rancidone/meatreader-esp/pcb/production/bom.csv

Designator | Footprint | Quantity | Value | LCSC Part #
C1, C5 | 0805 | 2 | 10uF
C10, C11, C6, C9 | 0603 | 4 | 100nF
C12, C2, C3, C7 | 0603 | 4 | 1uF
C13, C14, C15, C16 | 0603 | 4 | 47nF
C4, C8 | 0805 | 2 | 47uF
D1 | D_SMA_Handsoldering | 1 | SMAJ5 | C19077497
D2 | LED_D3.0mm | 1 | LED_PWR
D3 | LED_D3.0mm | 1 | LED_G
D4 | LED_D3.0mm | 1 | LED_R
D5 | D_SOD-323_HandSoldering | 1 | PESD3V3
D6, D7, D8, D9 | D_SOD-323_HandSoldering | 4 | PESD5V0
J1 | JST_PH_B2B-PH-K_1x02_P2.00mm_Vertical | 1 | BATT
J2 | USB_C_Receptacle_GCT_USB4125-xx-x_6P_TopMnt_Horizontal | 1 | USB_C_Receptacle_PowerOnly_6P
J3 | JST_PH_B3B-PH-K_1x03_P2.00mm_Vertical | 1 | DS18B20
J4 | PinHeader_2x03_P1.27mm_Vertical_SMD | 1 | PROG
R1, R3 | 0603 | 2 | 5K1
R10, R2 | 0603 | 2 | 100R
R11, R12, R17, R18 | 1206 | 4 | 22K
R13, R14, R19, R20 | 0603 | 4 | 470R
R15, R16, R9 | 0603 | 3 | 4K7
R4, R5 | 0603 | 2 | 1K | C11702
R6 | 0603 | 1 | 1K6
R7, R8 | 0603 | 2 | 10K
SW1 | JST_PH_B2B-PH-K_1x02_P2.00mm_Vertical | 1 | SW_SPST
SW2 | 6x3.5 Tactile Switch | 1 | RESET
SW3 | 6x3.5 Tactile Switch | 1 | BOOT
TH1, TH2, TH3, TH4 | PJ-209 | 4 | Thermistor
TP1, TP9 | TestPoint_THTPad_D2.5mm_Drill1.2mm | 2 | GND
TP11 | TestPoint_Pad_D2.5mm | 1 | AIN1
TP12 | TestPoint_Pad_D2.5mm | 1 | AIN2
TP2 | TestPoint_THTPad_D2.5mm_Drill1.2mm | 1 | 5V_USB
TP3 | TestPoint_THTPad_D2.5mm_Drill1.2mm | 1 | BATT
TP4 | TestPoint_THTPad_D2.5mm_Drill1.2mm | 1 | 3V3
TP7 | TestPoint_Pad_D2.5mm | 1 | AIN0
TP8 | TestPoint_Pad_D2.5mm | 1 | AIN3
U1 | SOT-23-5 | 1 | AP2112K-3.3
U2 | SOIC-8-1EP_3.9x4.9mm_P1.27mm_EP2.41x3.3mm | 1 | TP4056
U3 | ESP32-WROOM-32U | 1 | ESP32-WROOM-32U
U4 | TSSOP-10_3x3mm_P0.5mm | 1 | ADS1115
