rancidone/meatreader-esp/pcb/Lid.stl

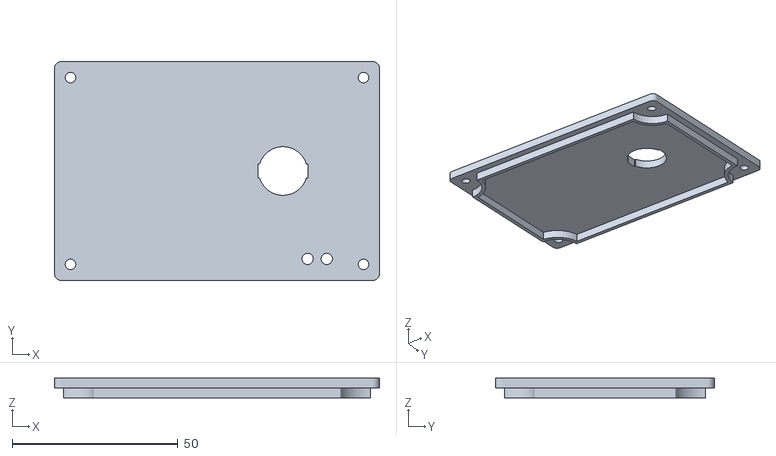
[picture p1: CAD file, 2026-11-08]
pcb/Lid.stl
98.0 x 66.0 x 6.00
