rancidone/meatreader-esp/pcb/meatreader.step

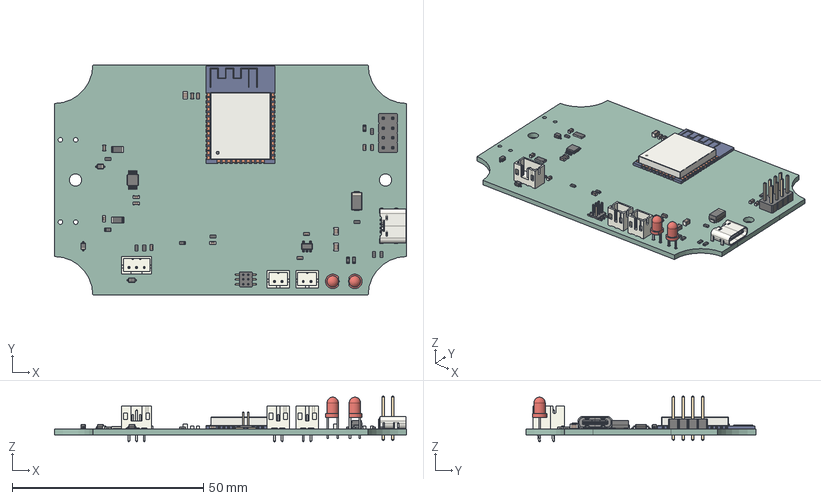
[picture p2: CAD file, 2026-11-08]
pcb/meatreader.step
92.0 x 60.0 x 11.9 mm
C_0603_1608Metric x 12
LED_D3.0mm x 2
PinHeader_2x03_P1.27mm_Vertical_SMD
D_SMA
R_1206_3216Metric x 2
D_SOD-323 x 3
R_0603_1608Metric x 13
USB_C_Receptacle_GCT_USB4125-xx-x_6P_TopMnt_Horizontal
C_0805_2012Metric x 3
JST_PH_B3B-PH-K_1x03_P2.00mm_Vertical
PinHeader_2x04_P2.54mm_Vertical
SOT-23-5
JST_PH_B2B-PH-K_1x02_P2.00mm_Vertical x 2
ESP32-WROOM-32
TSSOP-10_3x3mm_P0.5mm
meatreader_PCB
