rancidone/meatreader-esp/pcb/Pan.stl

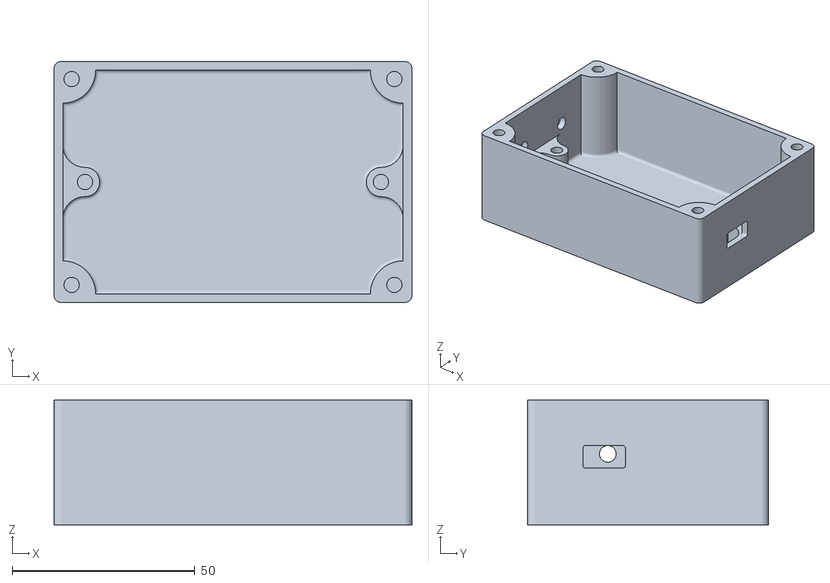
[picture p3: CAD file, 2026-11-08]
pcb/Pan.stl
98.0 x 66.0 x 34.1
