rancidone/meatreader-esp/(list of files, cad)

Other CAD files:
pcb/meatreader.stl
