rancidone/meatreader-esp/pcb/meatreader.kicad_pcb

## KiCad design pcb/meatreader.kicad_pcb (2026-11-08)

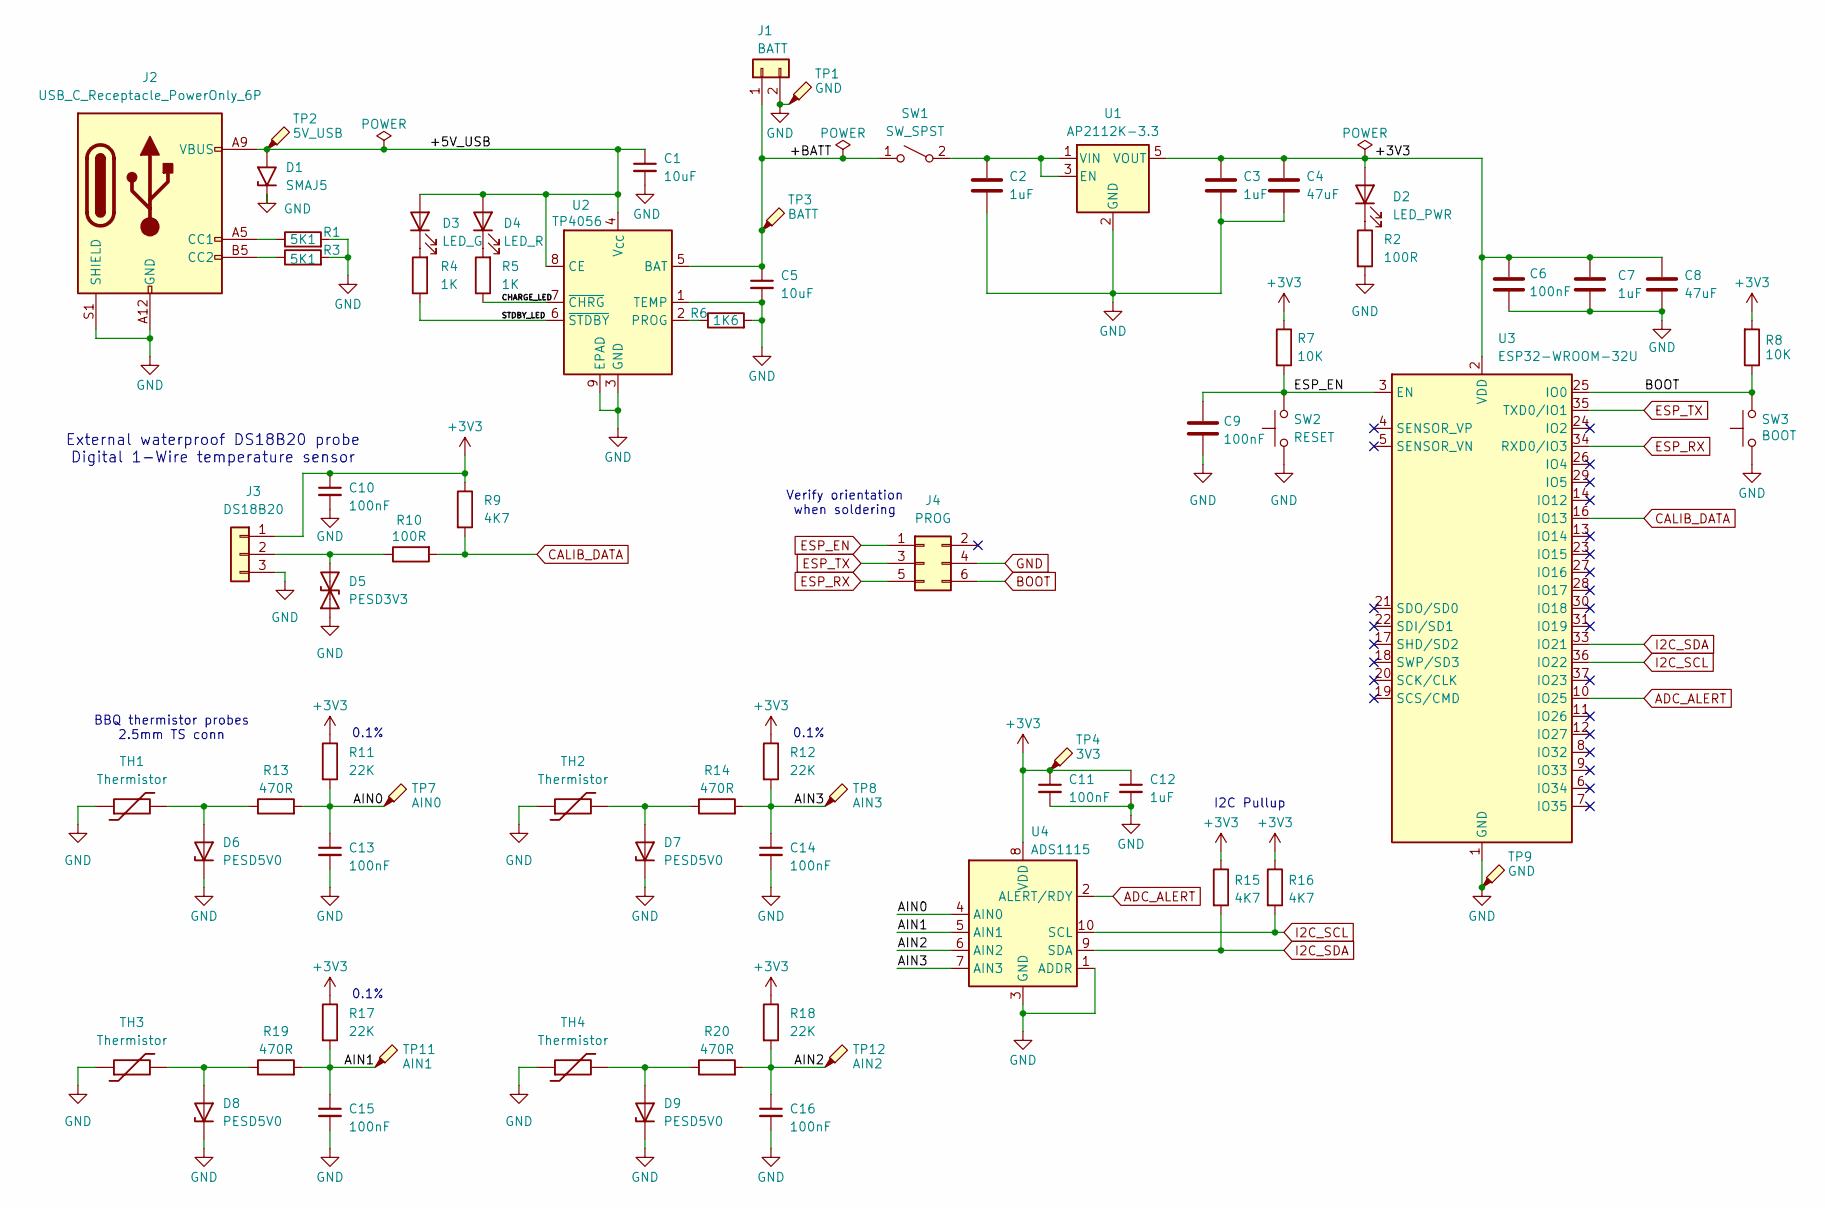
[picture p4: schematic meatreader.kicad_sch]

Parts:
C1, C5: 10uF; C_0805_2012Metric_Pad1.18x1.45mm_HandSolder
C2, C3, C7, C12: 1uF; C_0603_1608Metric_Pad1.08x0.95mm_HandSolder
C4: 47uF; R_0805_2012Metric_Pad1.20x1.40mm_HandSolder
C6, C9, C10, C11, C13, C14, C15, C16: 100nF; C_0603_1608Metric_Pad1.08x0.95mm_HandSolder
C8: 47uF; C_0805_2012Metric_Pad1.18x1.45mm_HandSolder
D1: SMAJ5; D_SMA_Handsoldering; LCSC C19077497
D2: LED_PWR; LED_D3.0mm
D3: LED_G; LED_D3.0mm
D4: LED_R; LED_D3.0mm
D5: PESD3V3; D_SOD-323_HandSoldering
D6, D7, D8, D9: PESD5V0; D_SOD-323_HandSoldering
J1: BATT; JST_PH_B2B-PH-K_1x02_P2.00mm_Vertical
J2: USB_C_Receptacle_PowerOnly_6P; USB_C_Receptacle_GCT_USB4125-xx-x_6P_TopMnt_Horizontal
J3: DS18B20; JST_PH_B3B-PH-K_1x03_P2.00mm_Vertical
J4: PROG; PinHeader_2x03_P1.27mm_Vertical_SMD
R1, R3: 5K1; R_0603_1608Metric_Pad0.98x0.95mm_HandSolder
R2: 100R; R_0603_1608Metric_Pad0.98x0.95mm_HandSolder
R4, R5: 1K; R_0603_1608Metric_Pad0.98x0.95mm_HandSolder; LCSC C11702
R6: 1K6; R_0603_1608Metric_Pad0.98x0.95mm_HandSolder
R7, R8: 10K; R_0603_1608Metric_Pad0.98x0.95mm_HandSolder
R9: 4K7; R_0603_1608Metric
R10: 100R; R_0603_1608Metric
R11, R12, R17, R18: 22K; R_1206_3216Metric_Pad1.30x1.75mm_HandSolder
R13, R14, R19, R20: 470R; R_0603_1608Metric_Pad0.98x0.95mm_HandSolder
R15, R16: 4K7; R_0603_1608Metric_Pad0.98x0.95mm_HandSolder
SW1: SW_SPST; JST_PH_B2B-PH-K_1x02_P2.00mm_Vertical
SW2: RESET; 6x3.5 Tactile Switch
SW3: BOOT; 6x3.5 Tactile Switch
TH1, TH2, TH3, TH4: Thermistor; PJ-209
TP1, TP9: GND; TestPoint_THTPad_D2.5mm_Drill1.2mm
TP2: 5V_USB; TestPoint_THTPad_D2.5mm_Drill1.2mm
TP3: BATT; TestPoint_THTPad_D2.5mm_Drill1.2mm
TP4: 3V3; TestPoint_THTPad_D2.5mm_Drill1.2mm
TP7: AIN0; TestPoint_Pad_D2.5mm
TP8: AIN3; TestPoint_Pad_D2.5mm
TP11: AIN1; TestPoint_Pad_D2.5mm
TP12: AIN2; TestPoint_Pad_D2.5mm
U1: AP2112K-3.3; SOT-23-5
U2: TP4056; SOIC-8-1EP_3.9x4.9mm_P1.27mm_EP2.41x3.3mm
U3: ESP32-WROOM-32U
U4: ADS1115; TSSOP-10_3x3mm_P0.5mm

Connections:
+3V3: C3.1, C4.1, C6.1, C7.1, C8.1, C10.1, C11.1, C12.1, D2.2 (A), J3.1, R7.1, R8.2, R9.1, R11.1, R12.1, R15.1, R16.1, R17.1, R18.1, TP4.1 (1_1), U1.5 (VOUT), U3.2 (VDD), U4.8 (VDD)
/+5V_USB: C1.1, D1.2 (A2), D3.2 (A), D4.2 (A), J2.A9 (VBUS), J2.B9 (VBUS), TP2.1 (1_1), U2.4 (V_{CC}), U2.8 (CE)
/+BATT: C5.1, J1.1, SW1.1 (B), TP3.1 (1_1), U2.5 (BAT)
/AIN0: C13.1, R11.2, R13.2, TP7.1 (1_1), U4.4 (AIN0)
/AIN1: C15.1, R17.2, R19.2, TP11.1 (1_1), U4.5 (AIN1)
/AIN2: C16.1, R18.2, R20.2, TP12.1 (1_1), U4.6 (AIN2)
/AIN3: C14.1, R12.2, R14.2, TP8.1 (1_1), U4.7 (AIN3)
/CHARGE_LED: R5.1, U2.7 (~CHRG)
/STDBY_LED: R4.1, U2.6 (~STDBY)
ADC_ALERT: U3.10 (IO25), U4.2 (ALERT/RDY)
BOOT: J4.6, R8.1, SW3.1, U3.25 (IO0)
CALIB_DATA: R9.2, R10.2, U3.16 (IO13)
ESP_EN: C9.1, J4.1, R7.2, SW2.2, U3.3 (EN)
ESP_RX: J4.5, U3.34 (RXD0/IO3)
ESP_TX: J4.3, U3.35 (TXD0/IO1)
GND: C1.2, C2.2, C3.2, C4.2, C5.2, C6.2, C7.2, C8.2, C9.2, C10.2, C11.2, C12.2, C13.2, C14.2, C15.2, C16.2, D1.1 (A1), D5.1 (A1), D6.1 (K), D7.1 (K), D8.1 (K), D9.1 (K), J1.2, J2.A12 (GND), J2.B12 (GND), J2.S1 (SHIELD), J2.SH, J3.3, J4.4, R1.2, R2.2, R3.2, R6.2, SW2.1, SW3.2, TH1.1, TH2.1, TH3.1, TH4.1, TP1.1 (1_1), TP9.1 (1_1), U1.2 (GND), U2.1 (TEMP), U2.3 (GND), U2.9 (EPAD), U3.1 (GND), U3.15 (GND), U3.38 (GND), U3.39 (GND), U4.1 (ADDR), U4.3 (GND)
I2C_SCL: R16.2, U3.36 (IO22), U4.10 (SCL)
I2C_SDA: R15.2, U3.33 (IO21), U4.9 (SDA)
unnamed: D2.1 (K), R2.1
unnamed: D3.1 (K), R4.2
unnamed: D4.1 (K), R5.2
unnamed: D5.2 (A2), J3.2, R10.1
unnamed: D6.2 (A), R13.1, TH1.2
unnamed: D7.2 (A), R14.1, TH2.2
unnamed: D8.2 (A), R19.1, TH3.2
unnamed: D9.2 (A), R20.1, TH4.2
unnamed: J2.A5 (CC1), R1.1
unnamed: J2.B5 (CC2), R3.1
unnamed: C2.1, SW1.2 (A), U1.1 (VIN), U1.3 (EN)
unnamed: R6.1, U2.2 (PROG)

Notes on the sheet:
0.1%
Verify orientation when soldering
BBQ thermistor probes 2.5mm TS conn
External waterproof DS18B20 probe Digital 1-Wire temperature sensor
I2C Pullup

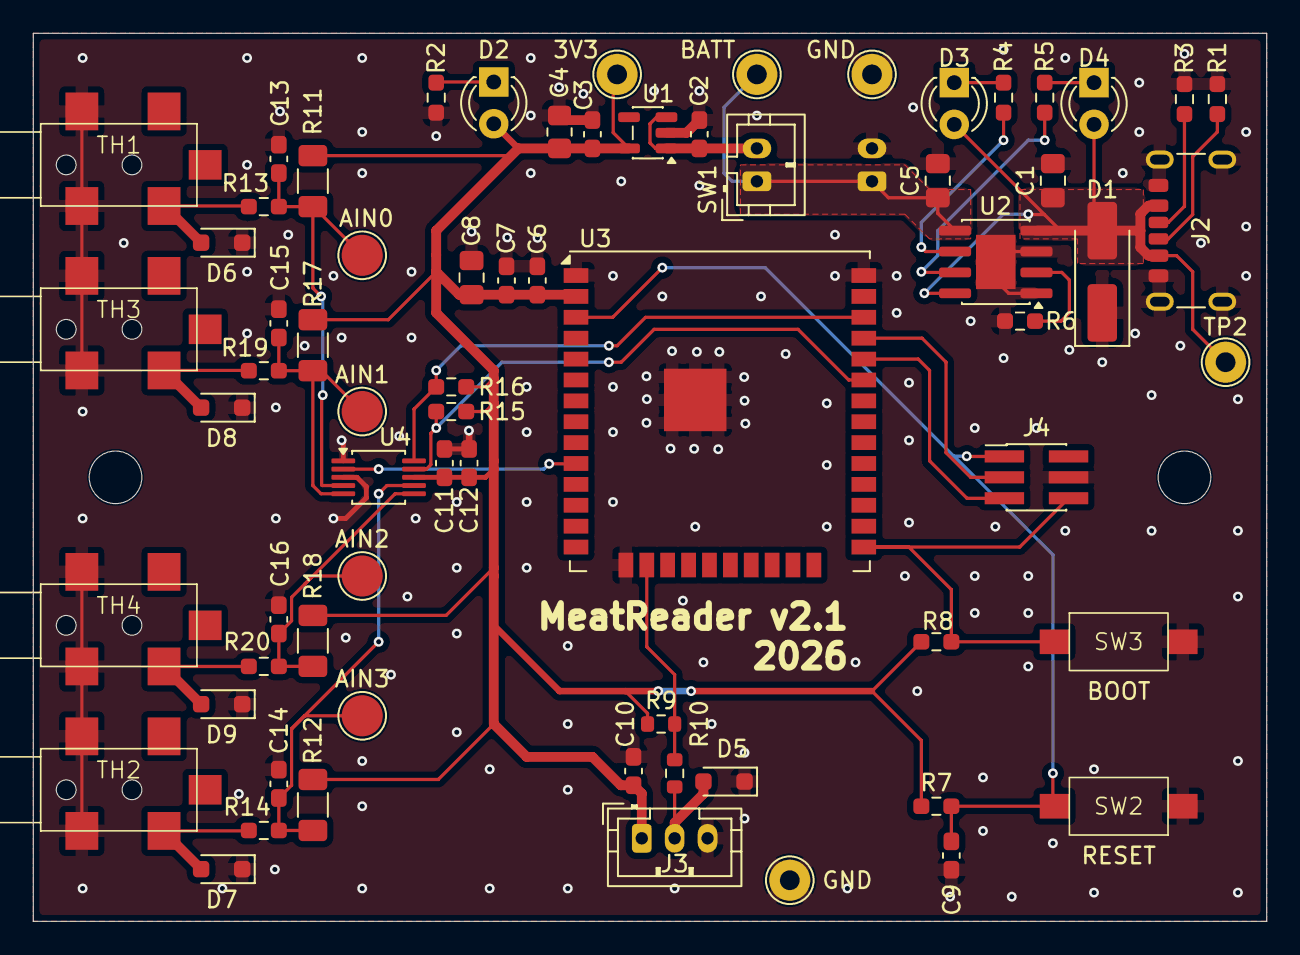
[picture p5: board meatreader.kicad_pcb from above]

Board: 2 copper layers, 75.0 x 54.0 mm, 69 parts (1 on the bottom side), 30 nets.
