rancidone/meatreader-esp/(commit log)

2026-03-08 Phase 1: cleanup stale Toit references and phantom fields
    - CLAUDE.md: remove toit-src/ from layout table
    - therm_math.c: remove "Coefficients from Toit prototype" comment
    - board.h: remove unused BOARD_NUM_CHANNELS macro
    - types.ts: update header to point to http_util.h; remove HistoryResponse,
    divider_resistor_ohms, publish_rate_hz
    - client.ts/live.ts: remove temps.history() and HistoryResponse re-exports
    - Config.svelte: remove localPublishRate state, form field, and table row
2026-03-08 Phases 3, 6, 7: unit tests, Prometheus metrics, sensor robustness
    Phase 3 — Unit tests:
    - firmware/tests/: CTest project with therm_math host-side tests (no ESP-IDF)
    - thermometer-ui: add Vitest + jsdom; types.test.ts and format.test.ts
    - vite.config.ts: add test block (jsdom, globals, src/**/*.test.ts)
    - CLAUDE.md: document Testing and Observability sections
    Phase 6 — Prometheus metrics:
    - routes_metrics.c: GET /metrics in Prometheus text format 0.0.4
    - Metrics: temperature, resistance, adc_raw, wifi_rssi_dbm, uptime, channel_quality
    - Register /metrics in http_server.c; add esp_wifi dep to CMakeLists
    - Add /metrics to Vite proxy targets
    Phase 7 — Hardware robustness:
    - sensor_mgr: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
2026-03-08 Phase 2: SoftAP captive portal for WiFi provisioning
    On first boot (or failed STA connect), the ESP32 starts a "Meatreader-Setup"
    SoftAP. A DNS hijack task redirects all queries to 192.168.4.1, triggering the
    OS captive portal popup. The inline HTML page (stored as a C string literal in
    routes_provision.c) accepts SSID/password, saves them to NVS via config_mgr,
    and reboots into STA mode. On subsequent boots, failed STA connection also falls
    back to SoftAP for re-provisioning.
    Changes:
    - wifi_mgr: add wifi_mgr_start_softap(), wifi_mgr_in_softap_mode(), UDP DNS
    hijack task (port 53 → 192.168.4.1)
    - http_server: dual URI table (normal vs provisioning); routes_provision.c with
    GET /, POS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
2026-03-08 feat(config_mgr): add alert types and schema versioning
    - Add alert_method_t enum (NONE, WEBHOOK, MQTT)
    - Add channel_alert_t struct (enabled, target_temp_c, method, webhook_url, triggered)
    - Add alerts[CONFIG_NUM_CHANNELS] and schema_version to device_config_t
    - Bump BLOB_VERSION to 2; add schema_version mismatch check in init
2026-03-08 feat(alerts): alert_mgr component, routes, UI integration
    - Add firmware/components/alert_mgr/ with alert_mgr_init/check_snapshot/deinit
    - FreeRTOS task polls sensor each second, fires on temp >= target (!triggered)
    - Hysteresis: clears triggered when temp drops 5°C below target
    - Webhook dispatch via esp_http_client in short-lived task
    - MQTT logs a warning (not yet implemented)
    - Wire alert_mgr_init in main.c after sensor_mgr_start
    - Add alert_mgr_t* to http_app_ctx_t in http_server.h
    - Add routes_alerts.c: GET /alerts, PATCH /alerts/staged
    - Register alert routes in http_server.c s_normal_uris[]
    - Extend apply_json_patch in routes_config.c to handle "alerts" array
    - Update channe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
2026-03-08 fix(clangd): portable stub for machine/endian.h
    The Xtensa newlib sysroot ships machine/endian.h but clangd on the host
    cannot find it — it is not in any explicit -I path, only the GCC built-in
    sysroot. Hardcoding ~/.espressif/ would break for other developers.
    Instead: firmware/clangd_stubs/ holds self-contained stubs for sysroot
    headers that ESP-IDF headers pull in transitively. firmware/.clangd adds
    -Iclangd_stubs so clangd resolves them without touching the real sysroot.
    The stub matches ESP32 (always little-endian) and uses __builtin_bswap*
    which clang supports natively.
2026-03-08 fix(build): direnv IDF env, esp_task_wdt→esp_system, esp_log→log
    - firmware/.envrc: direnv sources export.sh on directory entry so idf.py is
    available without manual sourcing; venv is scoped to firmware/ only
    - sensor_mgr: esp_task_wdt was merged into esp_system in this IDF version
    - alert_mgr: esp_log component is named 'log' in this IDF version
2026-03-08 feat: channel labels — firmware config_mgr + UI ChannelCard + Config
    Add char label[32] to channel_config_t; default to "Channel N" in apply_defaults
    and backfill from NVS blobs that predate the field. Emit label in
    channel_config_to_json; accept it in apply_json_patch (bounds-safe snprintf).
    Add label?: string to ChannelConfig TS type. ChannelCard accepts an optional
    label prop and shows it in the card header. Config.svelte adds a label text
    input per channel fieldset. Dashboard fetches config and passes active channel
    labels to ChannelCard.
2026-03-08 feat(ui): cook timer and predicted done time on ChannelCard
    Adds per-channel cook elapsed timer (HH:MM:SS) with Start/Stop controls,
    and a least-squares linear-regression ETA display (Done in ~HH:MM) when
    a target temperature is set and the channel is heating toward it.
2026-03-08 chore: mark done: cook timer + predicted done time (Phase 2 complete)
2026-03-08 feat(firmware): SSE /events endpoint with snapshot event group
    Add EventGroupHandle_t to sensor_mgr (signalled after each snapshot write),
    expose it via sensor_mgr_get_event_group(), and implement GET /events as a
    Server-Sent Events stream in routes_events.c that waits on bit 0 with a 5 s
    timeout (keep-alive ping on timeout, exit on send error).
2026-03-08 feat(ui): SSE EventSource replacing polling in tempsStore
    Rewrites live.ts to expose connectSSE() backed by EventSource('/events')
    instead of polling /temps/latest. tempsStore.start() now opens the SSE
    connection; stop() closes it. All other stores (config, device, calibration)
    continue using their existing fetch-based paths via the re-exported client.ts
    bindings. Adds /events to the Vite dev proxy.
2026-03-08 chore: compact TODO.md — remove completed phases 1-3
2026-03-08 Harden SSE stream handling and smooth noisy probe reads
2026-03-08 sensor_mgr: throttle repeated channel fault warnings
2026-03-08 feat: cook profile structs, NVS schema v3, and /profiles routes
    - Add stage_t, cook_profile_t, cook_profiles_t to config_mgr.h
    - Add cook_profiles_t cook field to device_config_t
    - Bump CONFIG_SCHEMA_VERSION and BLOB_VERSION to 3
    - Add routes_profiles.c: GET /profiles, PUT /profiles/{id}, DELETE /profiles/{id}
    - Register profile routes in http_server.c
2026-03-08 feat: cook profile UI (store, Profiles view, ChannelCard integration, stall badge)
    - Add Stage, CookProfile, ProfilesResponse types to types.ts; extend ChannelReading with stall_detected/stall_at
    - Create profileStore.svelte.ts: fetches /profiles (8 slots), starter library presets (Brisket, Pork Shoulder, Chicken Breast, Medium-Rare Beef, Medium Beef with USDA temps), localStorage selection persistence per channel, applyProfileToChannel patches config/staged+apply
    - Create Profiles.svelte: lists starter library (read-only) and custom API profile slots, inline create/edit forms (up to 4 stages in °F), apply-to-channel dropdowns
    - Update ChannelCard.svelte: profile selector dropdown, stall ba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
2026-03-08 feat: per-channel stall detection in alert_mgr, NVS schema v4
    - Add stall_alert_enabled to channel_alert_t in config_mgr.h
    - Bump CONFIG_SCHEMA_VERSION and BLOB_VERSION to 4 (NVS resets to defaults on mismatch)
    - Add stall_detected bool to channel_reading_t in sensor_mgr.h
    - Add sensor_mgr_set_stall_detected() so alert_mgr can write back stall state
    - Implement per-channel rolling window (1200 samples) in alert_mgr with ring buffer
    - Stall fires when abs(delta) < 2°C over 20 min; clears when temp rises > 1°C over 5 min
    - Stall alert dispatched via configured method (webhook/MQTT) once per stall event
    - Emit stall_detected in channel JSON via http_util.h channel_reading_to_json()
    - Add esp_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
2026-03-08 chore: mark Phase 4 stall detection TODO items complete
2026-03-08 Tighten agentkit governance thresholds and strict mode
2026-03-08 feat: Phase 5 PWA shell + service worker notifications
    - Add vite-plugin-pwa@1.2.0 with injectManifest strategy
    - Configure VitePWA plugin in vite.config.ts; add /profiles proxy
    - Create public/manifest.webmanifest (standalone display, amber theme)
    - Generate placeholder 192x192 and 512x512 PNG app icons
    - Add <link rel="manifest"> and theme-color meta to index.html
    - Create src/sw.ts: forwards snapshots from page via postMessage,
    fires Notification API on alert trigger and stall detection,
    handles notificationclick to focus/open window
    - Create src/lib/sw-bridge.ts: postSnapshotToSW / clearSWNotifications
    - Config.svelte: show Enable Notifications prompt when permission not yet granted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
2026-03-08 feat: Phase 5 UI polish, VAPID client, offline indicator, SW caching
    - App.svelte: global offline banner (red) when SSE disconnects; forward
    snapshots to service worker via sw-bridge on each tempsStore.latest change
    - sw.ts: network-first fetch handler caches /device and /config for
    offline display; prunes old caches on activate
    - vapid.ts: VAPID key generation (P-256 ECDH via WebCrypto), localStorage
    persistence, push subscription helpers (subscribeToPush/unsubscribeFromPush)
    - Config.svelte: Web Push subscribe/unsubscribe UI; evaluates PushManager
    availability; note firmware POST /push/notify endpoint is deferred
2026-03-08 feat: Phase 5 firmware POST /push/subscription + /push/notify endpoints
    - routes_push.c: store Web Push subscription (endpoint URL, p256dh, auth)
    in NVS namespace meatreader_push; relay outbound HTTP POST to push
    endpoint via esp_http_client on POST /push/notify
    - http_server.c: register /push/subscription and /push/notify routes
    - CMakeLists.txt: add routes_push.c, esp_http_client, nvs_flash deps
    - vite.config.ts: proxy /push to device in dev mode
    - Note: full VAPID JWT + AES-GCM payload encryption deferred (mbedtls
    supports ECDSA P-256; implementation is a future enhancement)
2026-03-09 feat: Phase 6 OTA firmware update endpoints + rollback
    - POST /ota: stream .bin to inactive partition, validate magic byte,
    set boot partition, restart; 64 KB minimum size guard
    - POST /ota/rollback: mark current partition invalid and reboot
    - wifi_mgr: call esp_ota_mark_app_valid_cancel_rollback() on IP acquire
    so a bad firmware that never connects WiFi auto-rolls back on reboot
    - sdkconfig.defaults: enable TWO_OTA partition table + bootloader rollback
    - CMakeLists: set PROJECT_VER "0.5.0" for esp_app_description_t.version
    - GET /device: expose firmware_version from esp_app_description_t
    - types.ts: add firmware_version field to DeviceResponse
    - http_server stack bumped to 16 KB for OTA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
2026-03-09 feat: Phase 6 OTA firmware implementation (partitions, routes_ota, version, rollback)
    - Add partitions.csv with ota_0, ota_1, otadata, storage layout for 4MB flash
    - Update sdkconfig.defaults to use custom partition table with rollback enabled
    - Add routes_ota.h public header declaring register_ota_routes()
    - Add register_ota_routes() implementation to routes_ota.c (routes registered via URI table)
    - Add #include "routes_ota.h" and call register_ota_routes() in http_server.c
    - Set recv_wait_timeout/send_wait_timeout = 30s on httpd_config for OTA streaming
    - routes_status.c GET /device already includes firmware_version via esp_app_get_description()
    - wifi_mgr.c already calls esp_ota_mark_app_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
2026-03-10 fix: correct OTA partition table layout and flash size (4MB)
    - Fix partition overlap: ota_0 moved to 0x20000 (otadata ended at 0x11000)
    - Both OTA slots 0x180000 (1.5MB), giving 33% headroom over current ~1MB firmware
    - Set flash size to 4MB in sdkconfig.defaults (required for dual OTA layout)
    - storage (SPIFFS) at 0x320000, 896KB
2026-03-10 feat: Phase 7 plan — serve web UI from ESP32 via SPIFFS
    Add TODO items for embedding built Svelte UI in SPIFFS partition,
    serving static files from http_server catch-all route with SPA fallback,
    and a combined build-all.sh script.
2026-03-10 feat: Phase 6 OTA UI (Firmware.svelte, firmware_version type, nav link)
    - Add firmware_version?: string to DeviceResponse type
    - Add OtaRollbackResponse interface
    - Create Firmware.svelte: drag-drop upload, XHR progress, state machine
    (idle→selected→confirm→uploading→flashing→rebooting→polling→done/error)
    - Post-upload polls GET /device until device comes back online
    - Warning modal before upload, rollback button via POST /ota/rollback
    - Add ota.rollback() to client.ts and re-export via live.ts
    - Add 'firmware' tab to App.svelte nav
2026-03-10 feat: Phase 7 firmware — SPIFFS mount, routes_static.c, partitions.csv
    - Add partitions.csv: nvs/otadata/ota_0/ota_1/storage(512KB SPIFFS)
    - Mount SPIFFS at /spiffs in main.c (non-fatal, warns on failure)
    - Add spiffs to main/CMakeLists.txt REQUIRES
    - Create routes_static.c: catch-all handler, MIME types, SPA fallback,
    Cache-Control immutable for /assets/, no-cache for index.html
    - Create routes_static.h header
    - Register /* handler last in http_server.c, bump max_uri_handlers
    - Add routes_static.c, spiffs, esp_vfs to http_server CMakeLists.txt
2026-03-11 chore: collapse completed phases in TODO.md
    Phases 4–7 all done; replaced verbose checklists with a summary Done
    section. Future and Notes sections unchanged.
2026-03-11 refactor: extract SPIFFS mount into storage component
    Add firmware/components/storage with storage_fs_init() and
    storage_fs_deinit() lifecycle API. Mount settings are unchanged:
    base_path=/spiffs, partition_label=storage, max_files=10,
    format_if_mount_failed=false. Uses esp_vfs_spiffs_register.
    Remove inline mount block from app_main; replace with
    storage_fs_init() call that returns esp_err_t for caller logging.
2026-03-11 feat(storage): add mount logging, capacity reporting, and mounted-state guard
    In storage_fs_init():
    - Classify mount errors: NOT_FOUND (partition missing), FAIL
    (corrupt filesystem), other (generic warning with esp_err_to_name)
    - On successful mount, call esp_spiffs_info() and log total/used KB
    - Move outcome logging from main.c into the storage module
    Add storage_fs_mounted() to public API so callers can gate on
    filesystem availability without re-checking mount state.
    In routes_static_handler(): guard at entry with storage_fs_mounted();
    return 503 if SPIFFS is not available instead of falling through to
    404 for every path (HTTP server and API routes unaffected).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
2026-03-11 chore: mark Phase 3-4 complete, gitignore .agentkit/tmp
    All TODO phases complete:
    - Phase 3: mount logging, capacity reporting, mounted-state guard
    - Phase 4: fullclean build pass, unit tests pass (1/1), log and
    static-asset behavior verified
    Add .agentkit/tmp/ to .gitignore for future private temp files.
2026-03-13 docs(readme): document native mobile app as primary product direction
    Native mobile app (React Native + Expo) is now the primary UX surface.
    Web UI is repositioned as local admin/setup console. PWA is no longer
    the recommended distribution path. TFT UI track noted as in-progress.
2026-03-13 docs(readme): capture v1 mobile feature scope
    Documents the minimum feature set for the first native app release:
    live dashboard, device connection by IP, cook profiles, alert visibility,
    and device health. Out-of-scope items (calibration, config, OTA) remain
    in the web admin console.
2026-03-13 feat(mobile-app): initialize Expo + TypeScript app with workspace structure
    Scaffolds mobile-app/ using create-expo-app (blank-typescript template,
    Expo 55). Wires in @meatreader/api-types via npm workspace. Creates
    src/api/client.ts (HTTP client over firmware API), src/store/device.ts
    (saved device registry stub), and src/screens/ + src/navigation/
    directory stubs for Phase 9. Typecheck passes clean.
2026-03-13 feat(mobile-app): implement polling hook, AsyncStorage device registry, and arch wiring
    - src/store/device.ts: AsyncStorage-backed saved device registry with
    add/remove/touch/active-IP helpers
    - src/api/usePolling.ts: interval polling hook that retains stale data
    on error and cancels cleanly on unmount
    - App.tsx: proof-of-concept entry wiring client + polling + device store;
    replaced by navigation shell in Phase 9
    - Adds @react-native-async-storage/async-storage dependency
2026-03-13 feat(mobile-app): add expo-router navigation shell with tab layout
    - Switches entry point to expo-router/entry (file-based routing)
    - app/_layout.tsx: root Stack with no header
    - app/index.tsx: redirects to /(tabs)/dashboard
    - app/(tabs)/_layout.tsx: tab bar with Dashboard / Devices / Profiles tabs
    - app/(tabs)/dashboard|devices|profiles.tsx: placeholder screens
    - Adds expo-router ~55.0.5, expo-linking, expo-constants,
    react-native-safe-area-context, react-native-screens
    - Adds scheme: meatreader to app.json for deep link support
2026-03-13 feat(mobile-app): implement instrument-panel dashboard UX
    - Large 40pt temperature tiles per enabled channel (2-column grid)
    - Alert and stall badges on individual tiles; alert border highlight
    - Quality indicator dot (ok=green, stale=orange, disabled=gray, error=red)
    - Connection banner shows live/disconnected/connecting state with device IP
    - Polls /temps/latest every 2s via usePolling; retains stale data on error
    - Graceful empty state when no device is configured
    - Last-updated timestamp at bottom of scroll view
2026-03-13 feat(mobile-app): implement device onboarding and management screen
    - IP/hostname text input with basic validation; auto-activates first device added
    - Saved device list: tap to activate (green border + dot), Remove button with confirm
    - Clears or reassigns active device when the active one is removed
    - KeyboardAvoidingView for iOS; FlatList for arbitrary device count
    - Empty state with onboarding hint
2026-03-13 feat(mobile-app): implement cook profiles and alerts screens
    - packages/meatreader-api-types: add AlertStatus / AlertsResponse types
    - src/api/client.ts: add getAlerts(), patchAlerts(), postConfigApply()
    - app/(tabs)/profiles.tsx: list non-empty profiles; Apply button patches
    PATCH /alerts/staged with stage targets then POST /config/apply
    - app/(tabs)/alerts.tsx: polls /temps/latest + /alerts every 3s; shows
    triggered alert rows with target temp, stall-detected section, and
    all-clear banner
    - app/(tabs)/_layout.tsx: add Alerts tab (bell icon)
2026-03-13 refactor(thermometer-ui): remove PWA install prompt and Web Push subscription UI
    Native mobile app is now the primary UX. Remove product work that no
    longer matches the roadmap:
    - App.svelte: drop beforeinstallprompt handler, install banner, and
    install-banner CSS — PWA install is not the distribution path
    - Config.svelte: drop Web Push subscribe/unsubscribe UI, pushSubscribed
    state, pushPending state, and push subscription check effect
    Retained: service worker (offline caching of /device + /config),
    sw-bridge snapshot forwarding (in-tab notifications), SW registration,
    and PWA manifest (web admin console benefits from basic caching).
2026-03-13 fix(thermometer-ui): narrow-screen responsiveness for mobile browser use
    - App.svelte: at ≤600px, topbar stacks wordmark above a scrollable tab
    row (overflow-x: auto, no scrollbar chrome); tab font/padding reduced;
    content padding tightened to 0.75rem sides
    - Dashboard.svelte: channel grid uses minmax(min(280px, 100%), 1fr) so
    cards don't overflow on 320px screens (single column auto-collapses)
    - tab buttons: white-space: nowrap prevents mid-label line breaks
2026-03-13 feat(api): add GET /dashboard consolidated endpoint for mobile clients
    Adds routes_dashboard.c with a single-call endpoint that returns snapshot
    + status + alerts atomically — reducing mobile round-trips from 3 to 1.
    snapshot is null (not 503) when no sensor data is available yet, so mobile
    clients always get a usable health response on first connect.
    Also adds DashboardResponse type to @meatreader/api-types, getDashboard()
    to MeatreaderClient, and documents the full HTTP API surface in README.md.
    Completes Phase 11: Firmware API Alignment for Native Clients.
2026-03-13 feat(mobile): add temperature history chart tab; clear Phase 8–11 todos
    Adds a Chart tab to the mobile app with a rolling 120-point history
    (4 min at 2 s poll), per-channel sparklines rendered with pure React
    Native layout (no external chart library), and a live legend showing
    the latest reading for each active channel.
    Clears all remaining active TODO items:
    - Phase 9: chart/history entry point implemented
    - Phase 9: defer decision recorded (config/cal/OTA out of v1 scope)
    - Phase 12: moved to Future section (blocked on TFT hardware selection)
    - Phases 8–11 promoted to Done
2026-03-13 chore: remove native mobile app; web-only going forward
    Drops mobile-app/ and packages/meatreader-api-types/ entirely.
    The web UI (thermometer-ui/) is the primary interface for both desktop
    and mobile browsers. Updates README and TODO to reflect this direction.
    types.ts restored to self-contained (no workspace dependency), carrying
    forward the type additions from Phase 11 (AlertStatus, DashboardResponse,
    ProfilesResponse, stall fields).
2026-03-13 fix: resolve main task stack overflow on boot
    device_config_t (~2 KB) was stack-allocated in app_main, exhausting the
    4096-byte main task stack during the boot sequence. Two fixes:
    - Raise CONFIG_ESP_MAIN_TASK_STACK_SIZE to 8192 in sdkconfig.defaults
    - Heap-allocate device_config_t in app_main (freed after WiFi init)
2026-06-19 fix: resolve ESP-IDF v6 component dependency build errors
    Add esp_driver_i2c to ads1115 and i2c_manager REQUIRES; replace unknown
    'json' component with espressif__cjson in alert_mgr (PRIV_REQUIRES) and
    http_server (REQUIRES). Add espressif/cjson managed dependency and fix
    rollup native module install for UI dist build.
2026-06-19 feat: hardware mapping fixes, simplified config, all-channel calibration
    - Fix open-circuit detection thresholds (raw 32000→22000, ohms 2M→500k)
    so floating AIN inputs at ~3.2V are correctly detected as open
    - Map probe channels to AIN1/AIN2 (AIN0/AIN3 unused on this board rev)
    - Add temperature_f to /temps/latest JSON response
    - Show °C/°F in sensor_mgr tick logs
    - Remove staged config layer — PATCH /config edits active directly;
    POST /config/commit persists to flash
    - Calibration endpoints now operate on all channels simultaneously;
    a single DS18B20 read is shared across channels per capture point
    - Bump CONFIG_SCHEMA_VERSION to 6 (NVS layout changed)
2026-06-21 fix: embed git hash in build version, fix UI rebuild pipeline, fix Console reactive loop
    - CMakeLists.txt: append short git hash to PROJECT_VER (e.g. 0.5.0-abc1234)
    so OTA updates are uniquely identifiable via GET /device firmware_version
    - http_server CMakeLists: switch to add_custom_target(ALL) so Svelte UI is
    built unconditionally on every idf.py build; fixes silent skip when dist/
    files were newer than tracked sources
    - Firmware.svelte: convert $derived.by to plain function to fix production
    build rendering function source as template text
    - Console.svelte: use untrack() when reading autoScroll in scroll $effect to
    break infinite reactive loop (effect_update_depth_exceeded)
2026-06-21 fix: break consoleLog.push() reactive loop via untrack
    push() reads this.entries (reactive $state) to spread it, which caused every
    $effect calling push() to track consoleLog.entries as a dependency. Writing
    entries inside the same call then re-triggered the effect infinitely.
    untrack() when reading entries breaks the cycle.
2026-06-21 fix: console logs events only, not every snapshot
    Removed per-snapshot logging that caused a 500-item list re-render every
    second. Console now logs only SSE errors/reconnects and device connectivity
    changes. All push() calls wrapped in untrack() to prevent reactive loops.
2026-06-21 fix: I2C bus recovery + sensor task stack increase to prevent freeze
    When the ADS1115 gets into a bad state (SDA held low after a glitch),
    all channels error continuously. After 3 such cycles the sensor task now
    calls i2c_master_bus_reset() to flush the stuck slave before the task
    watchdog would fire and reset the whole chip.
    Also increases sensor_mgr task stack from 4096 → 6144 bytes to give the
    I2C driver and floating-point math adequate headroom.
2026-06-21 feat: cook profile stage alerts, UI blink, firmware history ring buffer
    Alert watcher (UI):
    - alertWatcher.svelte.ts tracks alert_triggered transitions per channel
    - When a stage target is hit: fires browser Notification, advances to next
    stage (patches config with next target_temp_c), or marks cook complete
    and disables the alert on final stage
    - ChannelCard pulses amber border while alert is active; click to dismiss
    - App.svelte drives alertWatcher.processSnapshot() on every SSE tick
    Console tab removed:
    - Deleted Console.svelte and consoleLog.svelte.ts
    - Removed from App.svelte tab list and route block
    Firmware temperature history (GET /temps/history):
    - sensor_mgr accumulates 1-min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
2026-06-21 feat: quick target input, chart expand fix, sparkline resize, build timestamp
    - Fix expand: sparkline onclick uses explicit arrow fn instead of {onclick} shorthand
    - Fix sparkline resize: ResizeObserver redraws canvas when CSS height changes (56→96px at 640px+)
    - Fix profileStore .staged.alerts → .alerts (config API returns DeviceConfig directly)
    - Add quick target number input on channel card — bypasses profile, patches alert directly
    - Remove chart series fills that were anchoring to y=0 and creating heavy overlap
    - Add History label to dashboard time-window dropdown
    - Expose build_date/build_time from esp_app_desc in /device; show in Firmware tab
    - Add 5 new starter profiles: Chicke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
2026-06-21 feat: seed history from firmware ring buffer on dashboard mount
2026-06-21 feat: 15s history samples, 1440 points (6h at 15s resolution)
2026-11-08 Add four-channel support and PCB design
